hackffm/FPVCar/python/web/00_Orientation_Size/horizontal.jpg

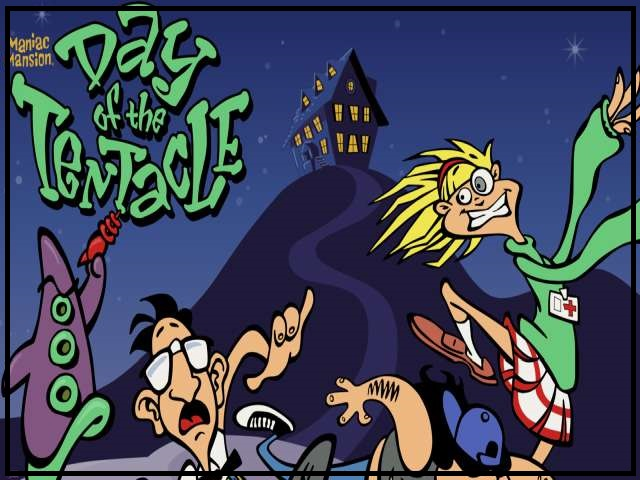
python/web/00_Orientation_Size/horizontal.jpg
