hackffm/FPVCar/python/web/00_Orientation_Size/vertical.jpg

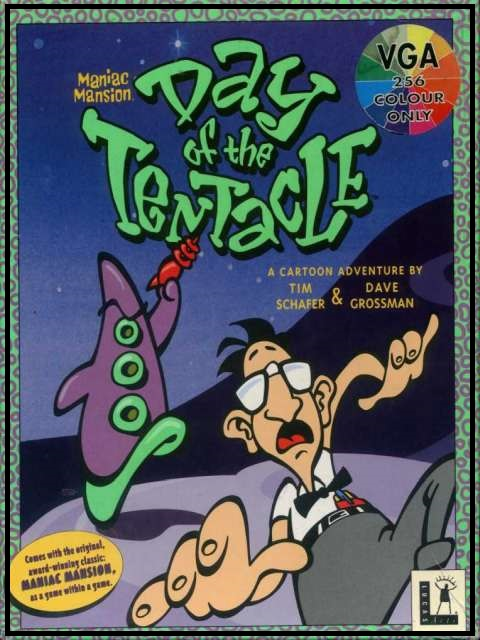
python/web/00_Orientation_Size/vertical.jpg
