hackffm/FPVCar/README.md

# FPVCar
First Person View Car

## Project Page
[FPV_Auto](https://hackerspace-ffm.de/wiki/index.php?title=FPV-Auto) @ HackFFM
