hackffm/FPVCar/PCB/Block diagram FPV Auto Shield.png

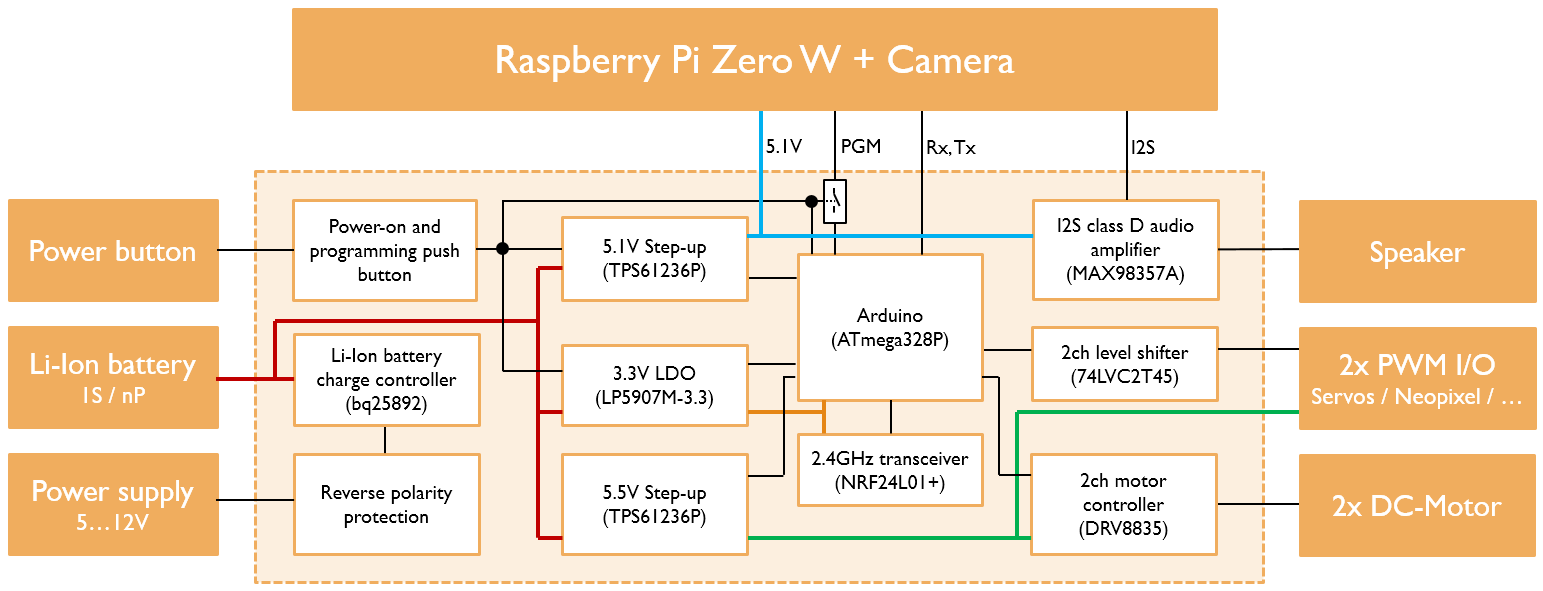
PCB/Block diagram FPV Auto Shield.png
