hackffm/FPVCar/PCB/MountBottomFirst.png

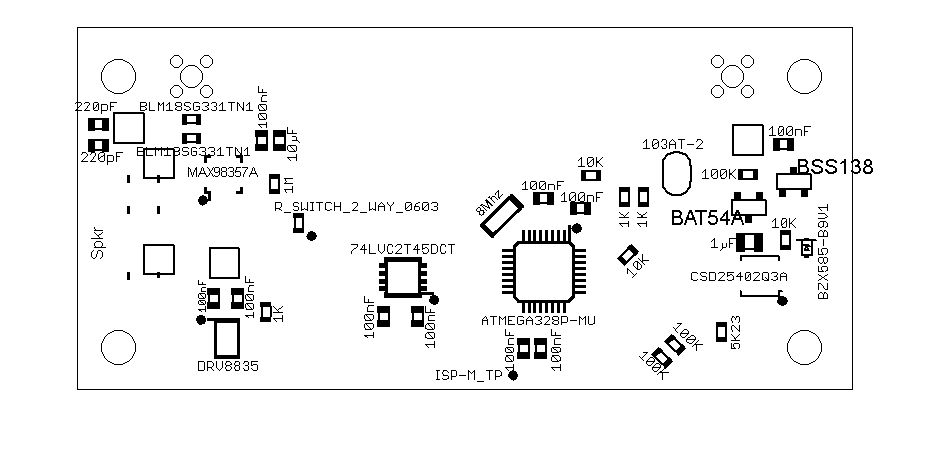
PCB/MountBottomFirst.png
