hackffm/FPVCar/PCB/MountTopSecond.png

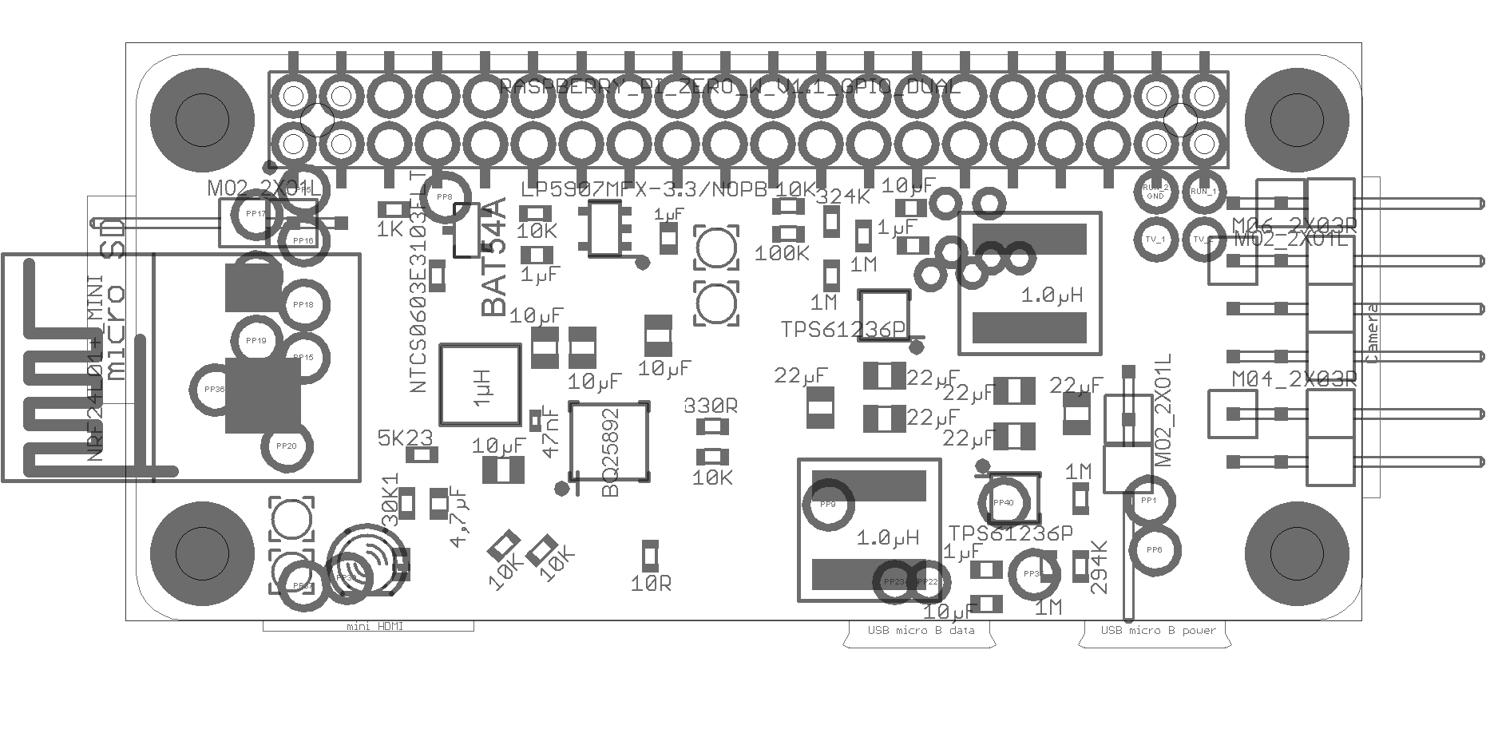
PCB/MountTopSecond.png
