hackffm/FPVCar/(threads)

Thread 1 (2019-05-06):

Wire.requestFrom() should not be followed by Wire.endTransmission().

Koepel, 2019-05-06:
In the file "FPVCar/arduino/FPVAutoControl/FPVAutoControl.ino" the `Wire.requestFrom()` is followed by a `Wire.endTransmission()`. That `Wire.endTransmission()` is at the moment at line 60 and may be removed.
Explanation: [Common-mistakes#2](https://github.com/Koepel/How-to-use-the-Arduino-Wire-library/wiki/Common-mistakes#2)

vkuehn, 2019-11-18:
this has been now fixed

Closed 2019-11-18.
