hackffm/FPVCar/PCB/FPV-Auto Schematic.pdf

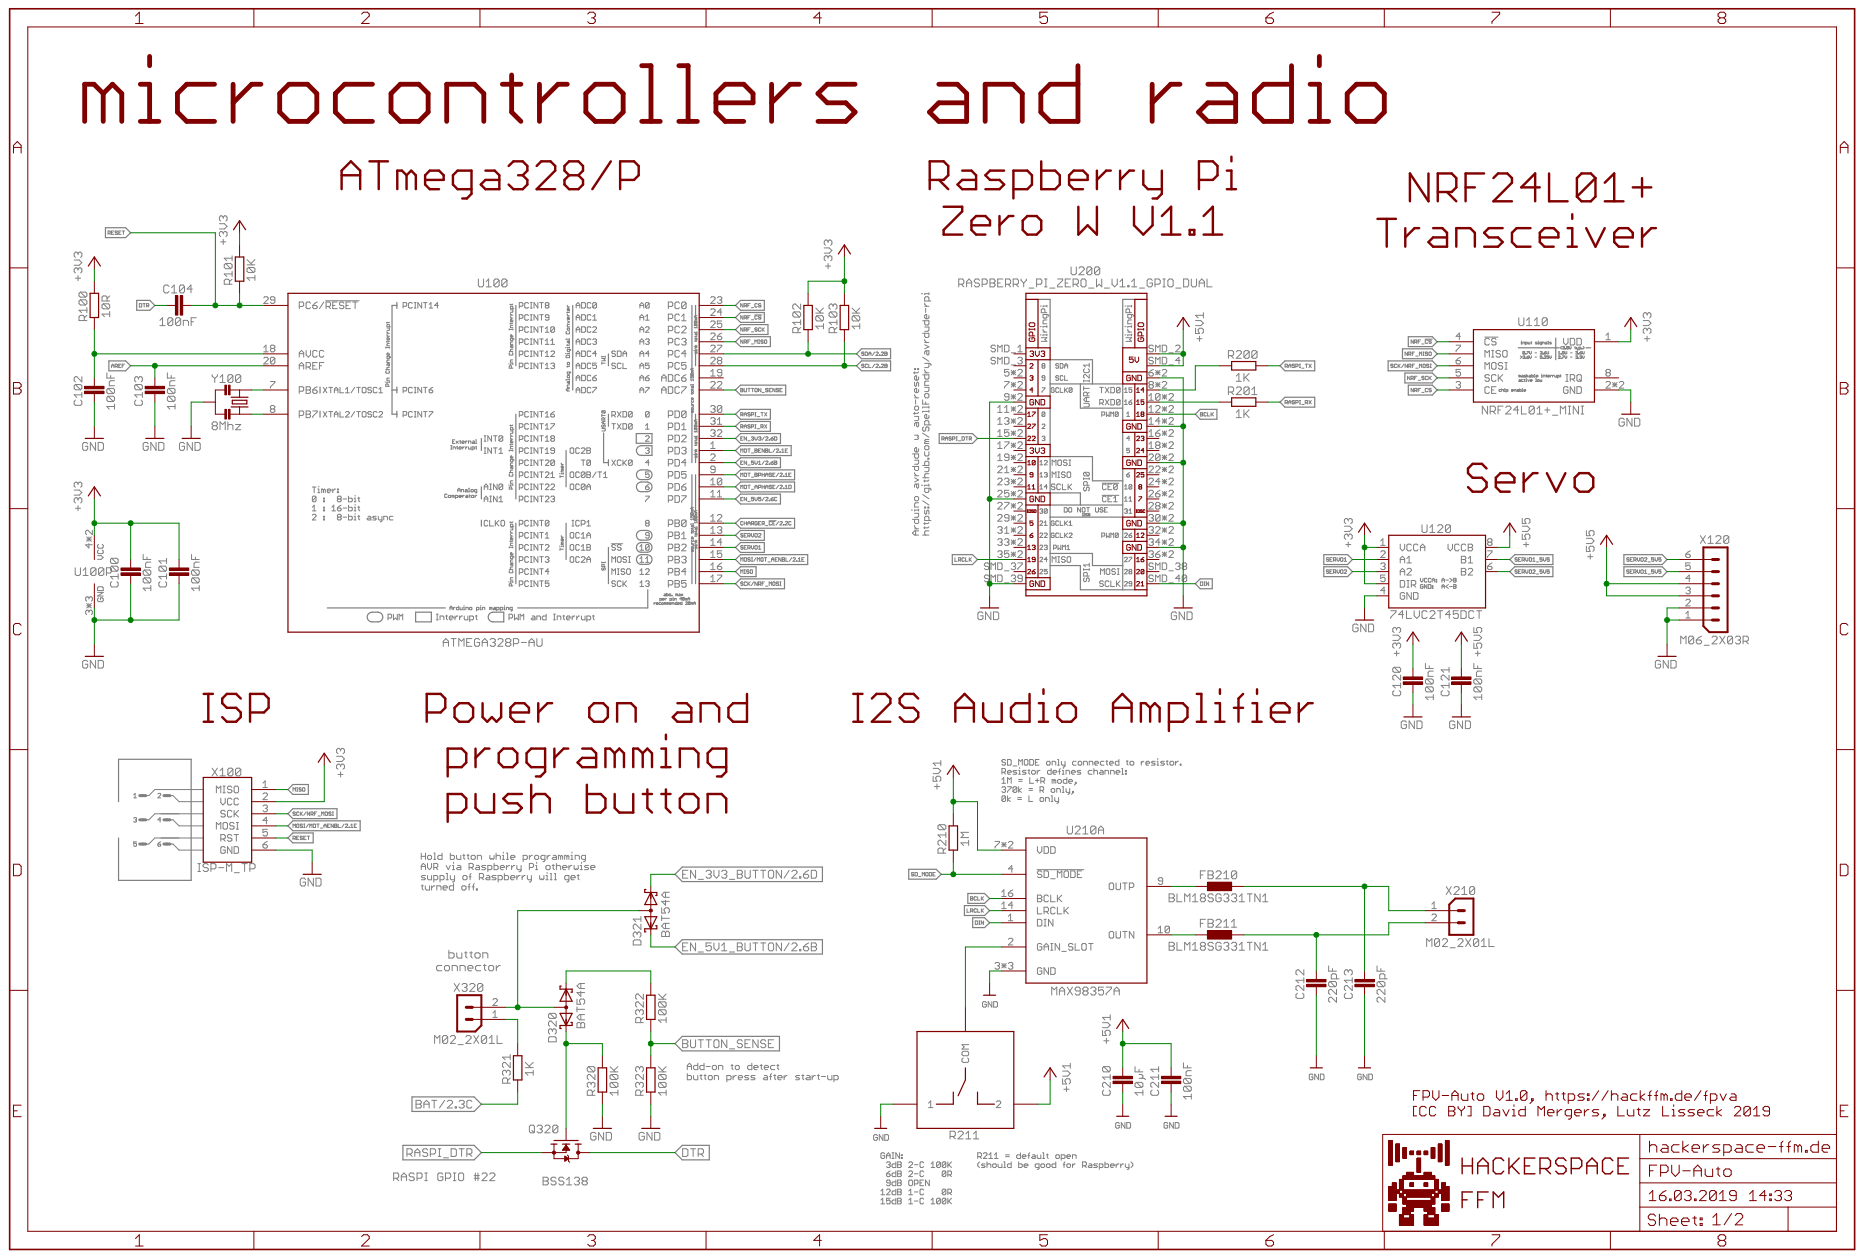
[picture p6: page 1]

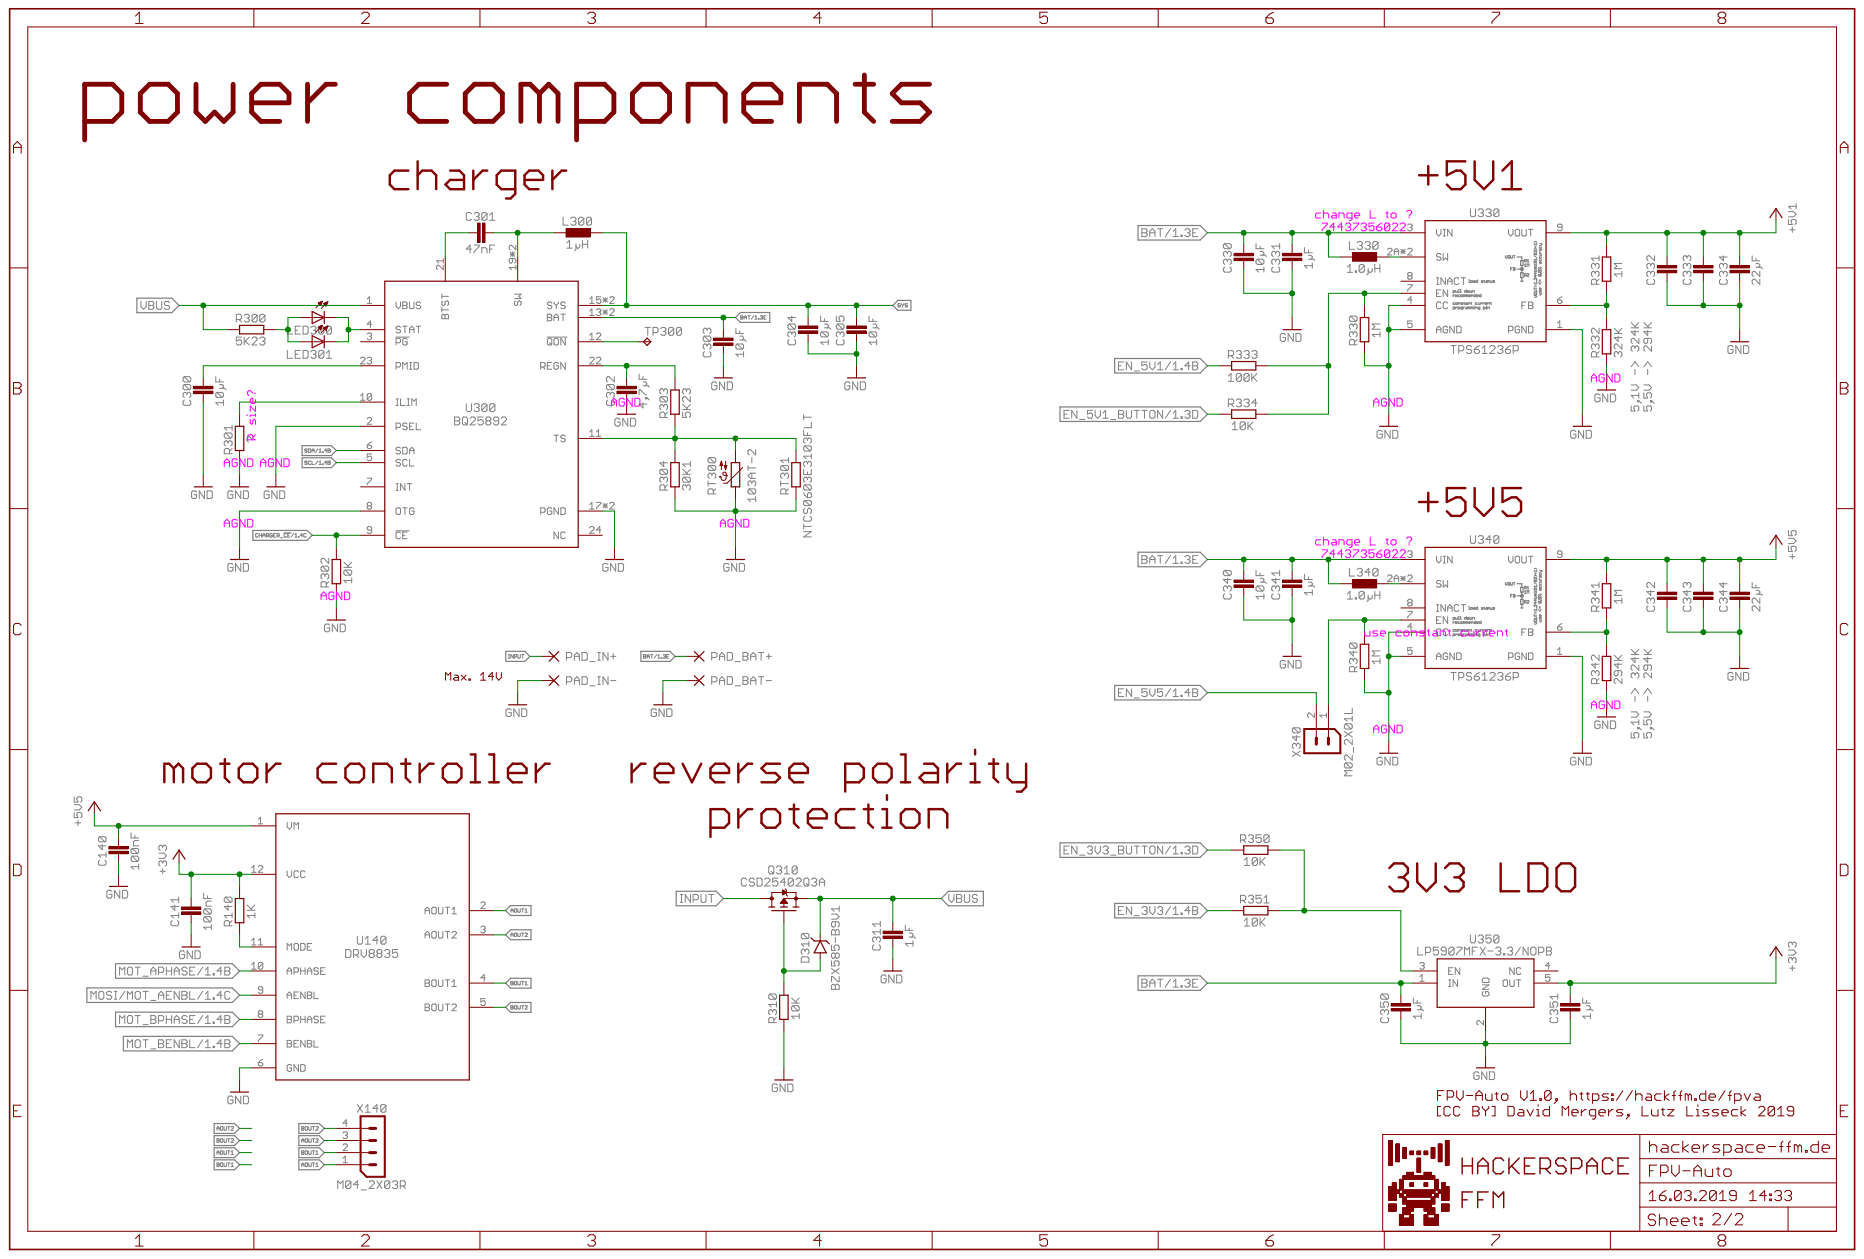
[picture p7: page 2]
