hackffm/FPVCar/(list of files, drawings)

Other design files:
arduino/hardware/FPVAuto/avr/avrdude-gpio-autoreset/diagrams/RPi Arduino Wire Up (Fritzing).fzz
