hackffm/FPVCar/PCB/FPV-Auto.brd

## EAGLE design PCB/FPV-Auto.brd (2019-08-17)

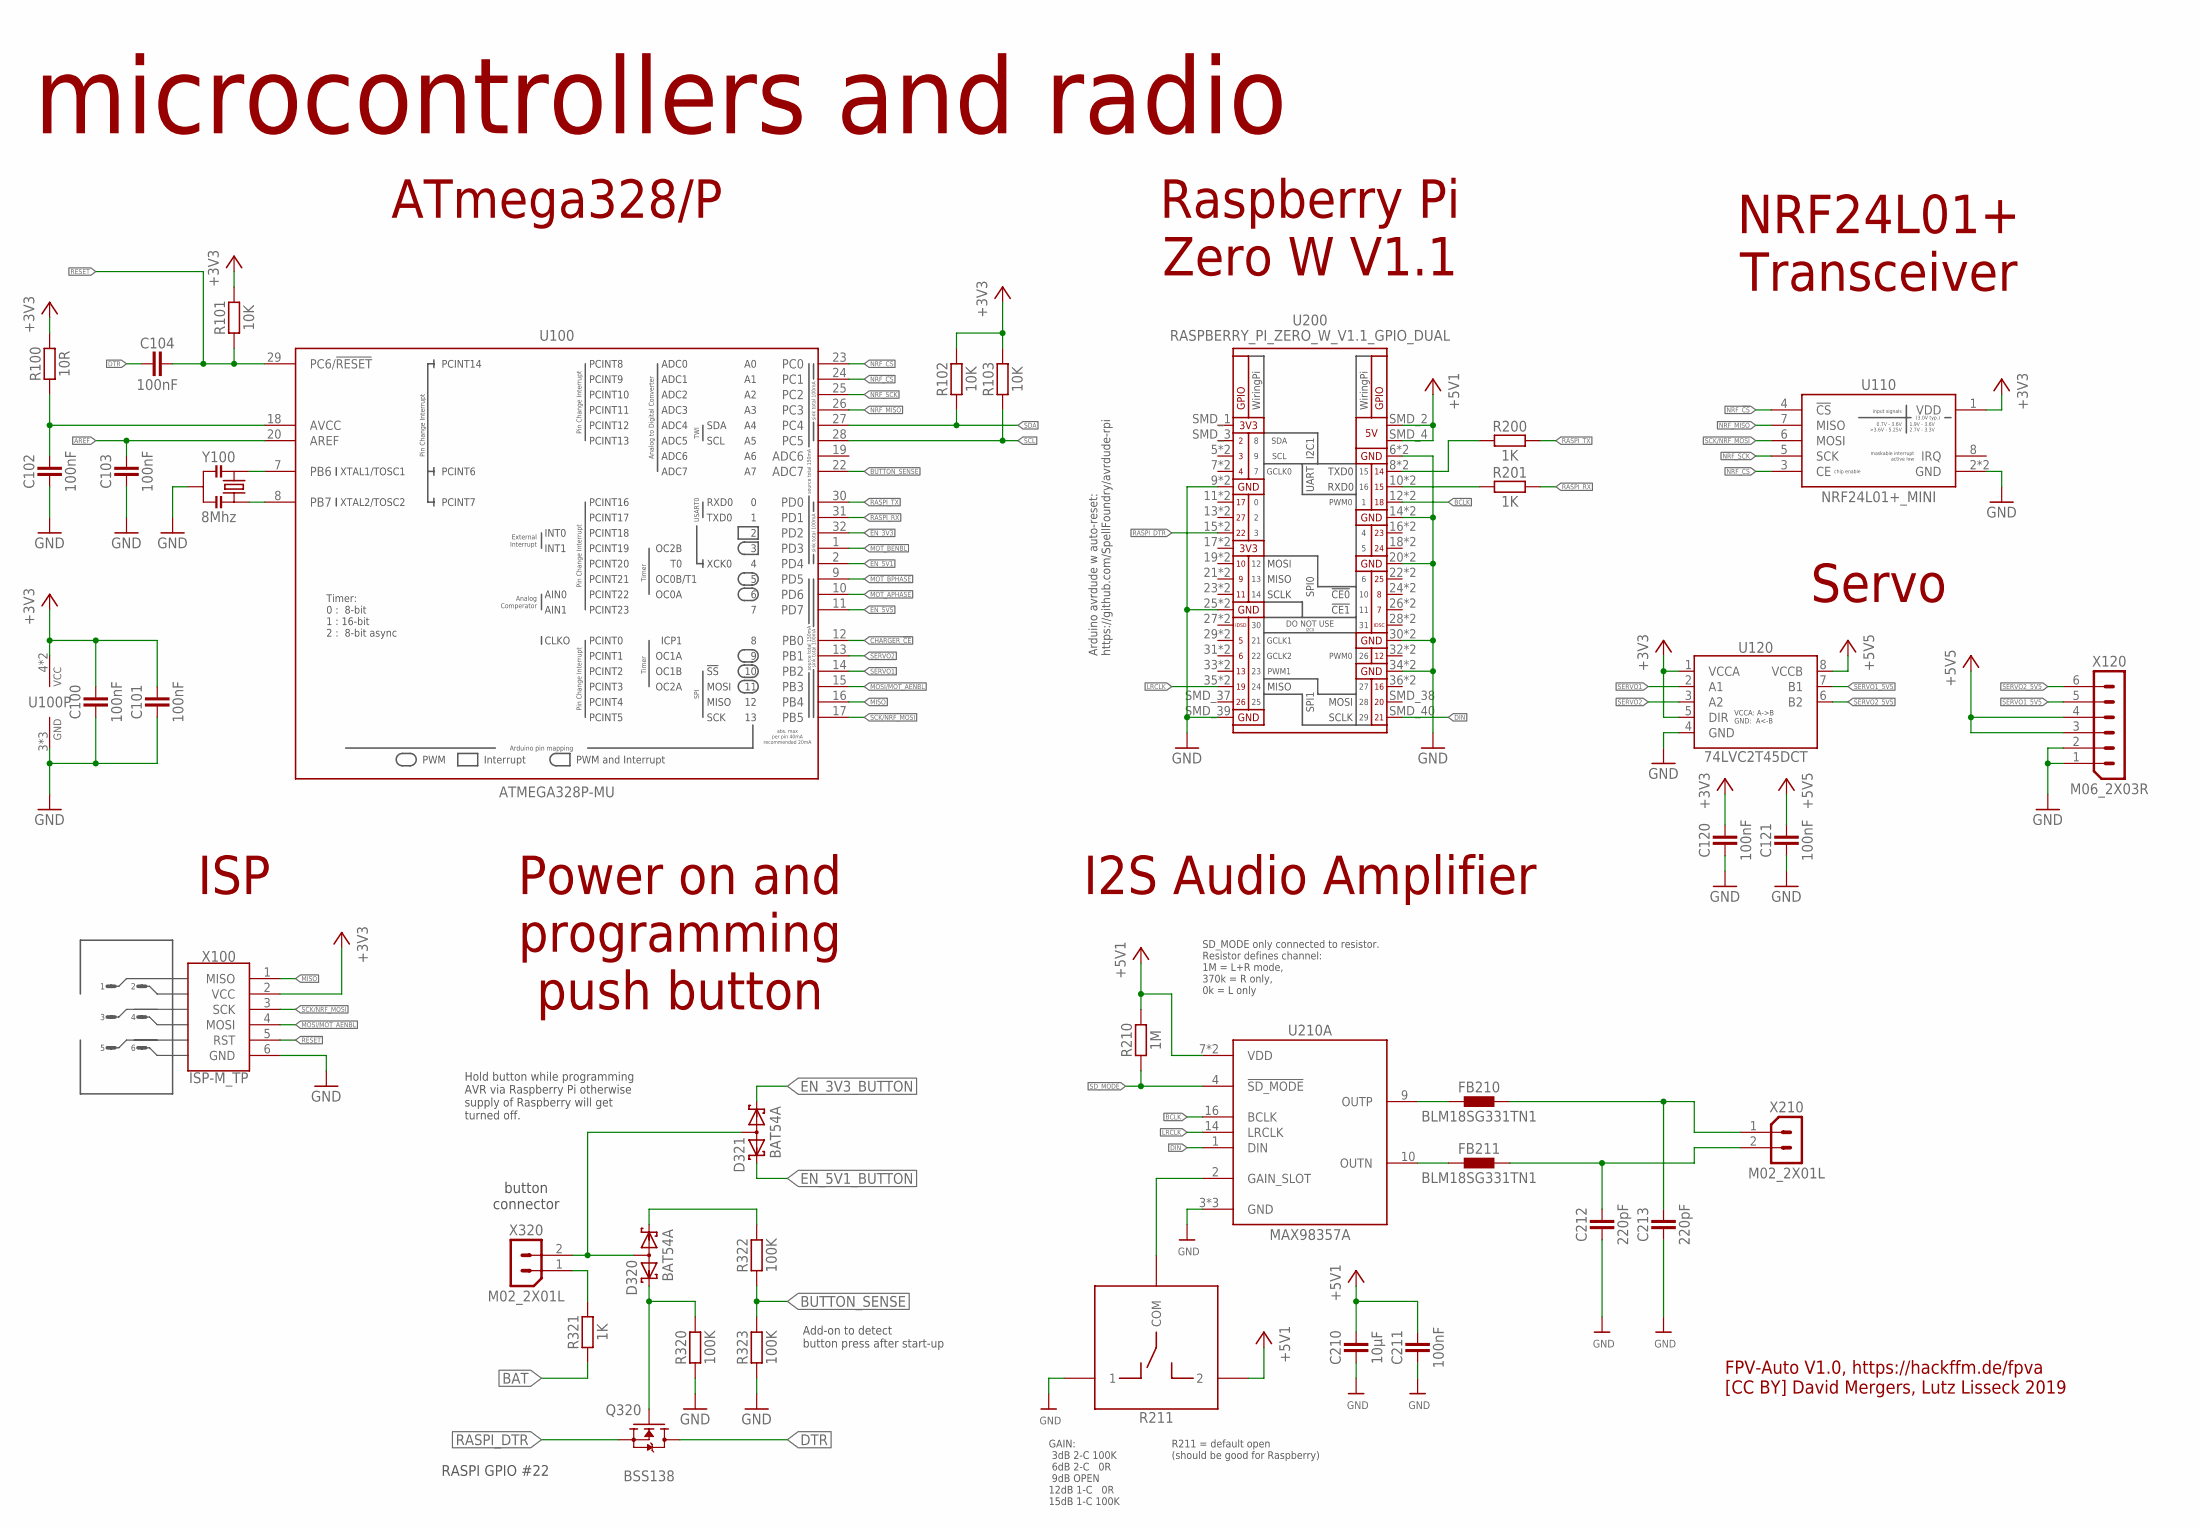
[picture p8: schematic FPV-Auto.sch, sheet 1]

Parts:
C100, C101, C102, C103, C104, C120, C121, C211: 100nF; C0603
C210: 10µF; C0603
C212, C213: 220pF; C0603
D320, D321: BAT54A; SOT23
FB210, FB211: BLM18SG331TN1; 0603
Q320: BSS138; SOT23-3
R100: 10R; R0603
R101, R102, R103: 10K; R0603
R200, R201, R321: 1K; R0603
R210: 1M; R0603
R211: R_SWITCH_2_WAY_0603; R0603_SWITCH_2_WAY
R320, R322, R323: 100K; R0603
U100: ATMEGA328P-MU; PBS(S-PQFP-G32)
U110: NRF24L01+_MINI
U120: 74LVC2T45DCT; DCT(R-PDSO-G8)
U200: RASPBERRY_PI_ZERO_W_V1.1_GPIO_DUAL
U210: MAX98357A; 90-0031
X100: ISP-M_TP
X120: M06_2X03R; M2X03R
X210, X320: M02_2X01L; M2X01L
Y100: 8Mhz; CSTNE

Connections:
+3V3: C100.1, C101.1, C120.1, R100.2, R101.2, R102.2, R103.2, U100.4 (VCC), U100.6 (VCC), U110.1 (VDD), U120.1 (VCCA), U120.5 (DIR), X100.2 (VCC); also elsewhere on the board
+5V1: C210.1, C211.1, R210.2, R211.2, U200.SMD_2 (5V), U200.SMD_4 (5V), U210.7 (VDD), U210.8 (VDD); also elsewhere on the board
+5V5: C121.1, U120.8 (VCCB), X120.3, X120.4; also elsewhere on the board
AREF: C103.1, U100.20 (AREF)
BAT: R321.2; also elsewhere on the board
BCLK: U200.12 (GPIO18), U200.SMD_12 (GPIO18), U210.16 (BCLK)
BUTTON_SENSE: R322.1, R323.2, U100.22 (ADC7)
CHARGER_!CE: U100.12 (PB0); also elsewhere on the board
DIN: U200.SMD_40 (GPIO21), U210.1 (DIN)
DTR: C104.2, Q320.3 (D)
EN_3V3: U100.32 (PD2); also elsewhere on the board
EN_3V3_BUTTON: D321.1 (K1); also elsewhere on the board
EN_5V1: U100.2 (PD4); also elsewhere on the board
EN_5V1_BUTTON: D321.2 (K2); also elsewhere on the board
EN_5V5: U100.11 (PD7); also elsewhere on the board
GAIN: R211.COM, U210.2 (GAIN_SLOT)
GND: C100.2, C101.2, C102.2, C103.2, C120.2, C121.2, C210.2, C211.2, C212.2, C213.2, R211.1, R320.1, R323.1, U100.3 (GND), U100.5 (GND), U100.21 (GND), U110.2 (GND), U110.9 (GND), U120.4 (GND), U200.6 (GND), U200.9 (GND), U200.14 (GND), U200.20 (GND), U200.25 (GND), U200.30 (GND), U200.34 (GND), U200.SMD_6 (GND), U200.SMD_9 (GND), U200.SMD_14 (GND), U200.SMD_20 (GND), U200.SMD_25 (GND), U200.SMD_30 (GND), U200.SMD_34 (GND), U200.SMD_39 (GND), U210.3 (GND), U210.11 (GND), U210.15 (GND), U210.TP0 (GND), U210.TP1 (GND), X100.6 (GND), X120.1, X120.2, Y100.2; also elsewhere on the board
LRCLK: U200.35 (GPIO19), U200.SMD_35 (GPIO19), U210.14 (LRCLK)
MISO: U100.16 (PB4), X100.1 (MISO)
MOSI/MOT_AENBL: U100.15 (PB3), X100.4 (MOSI); also elsewhere on the board
MOT_APHASE: U100.10 (PD6); also elsewhere on the board
MOT_BENBL: U100.1 (PD3); also elsewhere on the board
MOT_BPHASE: U100.9 (PD5); also elsewhere on the board
unnamed: D320.3 (AA), D321.3 (AA), X320.2
unnamed: FB211.1, U210.10 (OUTN)
unnamed: FB210.1, U210.9 (OUTP)
unnamed: U100.8 (PB7), Y100.3
unnamed: U100.7 (PB6), Y100.1
unnamed: D320.2 (K2), R322.2
unnamed: D320.1 (K1), Q320.1 (G), R320.2
unnamed: R321.1, X320.1
unnamed: C102.1, R100.1, U100.18 (AVCC)
unnamed: R200.1, U200.8 (GPIO14/TXD0), U200.SMD_8 (GPIO14/TXD0)
unnamed: R201.1, U200.10 (GPIO15/RXD0), U200.SMD_10 (GPIO15/RXD0)
NRF_!CS: U100.24 (PC1), U110.4 (!CS)
NRF_CS: U100.23 (PC0), U110.3 (CE)
NRF_MISO: U100.26 (PC3), U110.7 (MISO)
NRF_SCK: U100.25 (PC2), U110.5 (SCK)
RASPI_DTR: Q320.2 (S), U200.15 (GPIO22/GEN3), U200.SMD_15 (GPIO22/GEN3)
RASPI_RX: R201.2, U100.31 (PD1)
RASPI_TX: R200.2, U100.30 (PD0)
RESET: C104.1, R101.1, U100.29 (PC6/!RESET!), X100.5 (RST)
SCK/NRF_MOSI: U100.17 (PB5), U110.6 (MOSI), X100.3 (SCK)
SCL: R103.1, U100.28 (PC5); also elsewhere on the board
SDA: R102.1, U100.27 (PC4); also elsewhere on the board
SD_MODE: R210.1, U210.4 (!SD_MODE)
SERVO1: U100.14 (PB2), U120.2 (A1)
SERVO1_5V5: U120.7 (B1), X120.5
SERVO2: U100.13 (PB1), U120.3 (A2)
SERVO2_5V5: U120.6 (B2), X120.6
VO+: C213.1, FB210.2, X210.1
VO-: C212.1, FB211.2, X210.2

Notes on the sheet:
microcontrollers and radio
NRF24L01+ Transceiver
Raspberry Pi Zero W V1.1
ATmega328/P
GAIN: 3dB 2-C 100K 6dB 2-C 0R 9dB OPEN 12dB 1-C 0R 15dB 1-C 100K
ISP
I2S Audio Amplifier
Servo
button connector
RASPI GPIO #22
Power on and programming push button
SD_MODE only connected to resistor. Resistor defines channel: 1M = L+R mode, 370k = R only, 0k = L only
R211 = default open (should be good for Raspberry)
Arduino avrdude w auto-reset: https://github.com/SpellFoundry/avrdude-rpi
Hold button while programming AVR via Raspberry Pi otherwise supply of Raspberry will get turned off.
Add-on to detect button press after start-up
FPV-Auto V1.0, https://hackffm.de/fpva [CC BY] David Mergers, Lutz Lisseck 2019

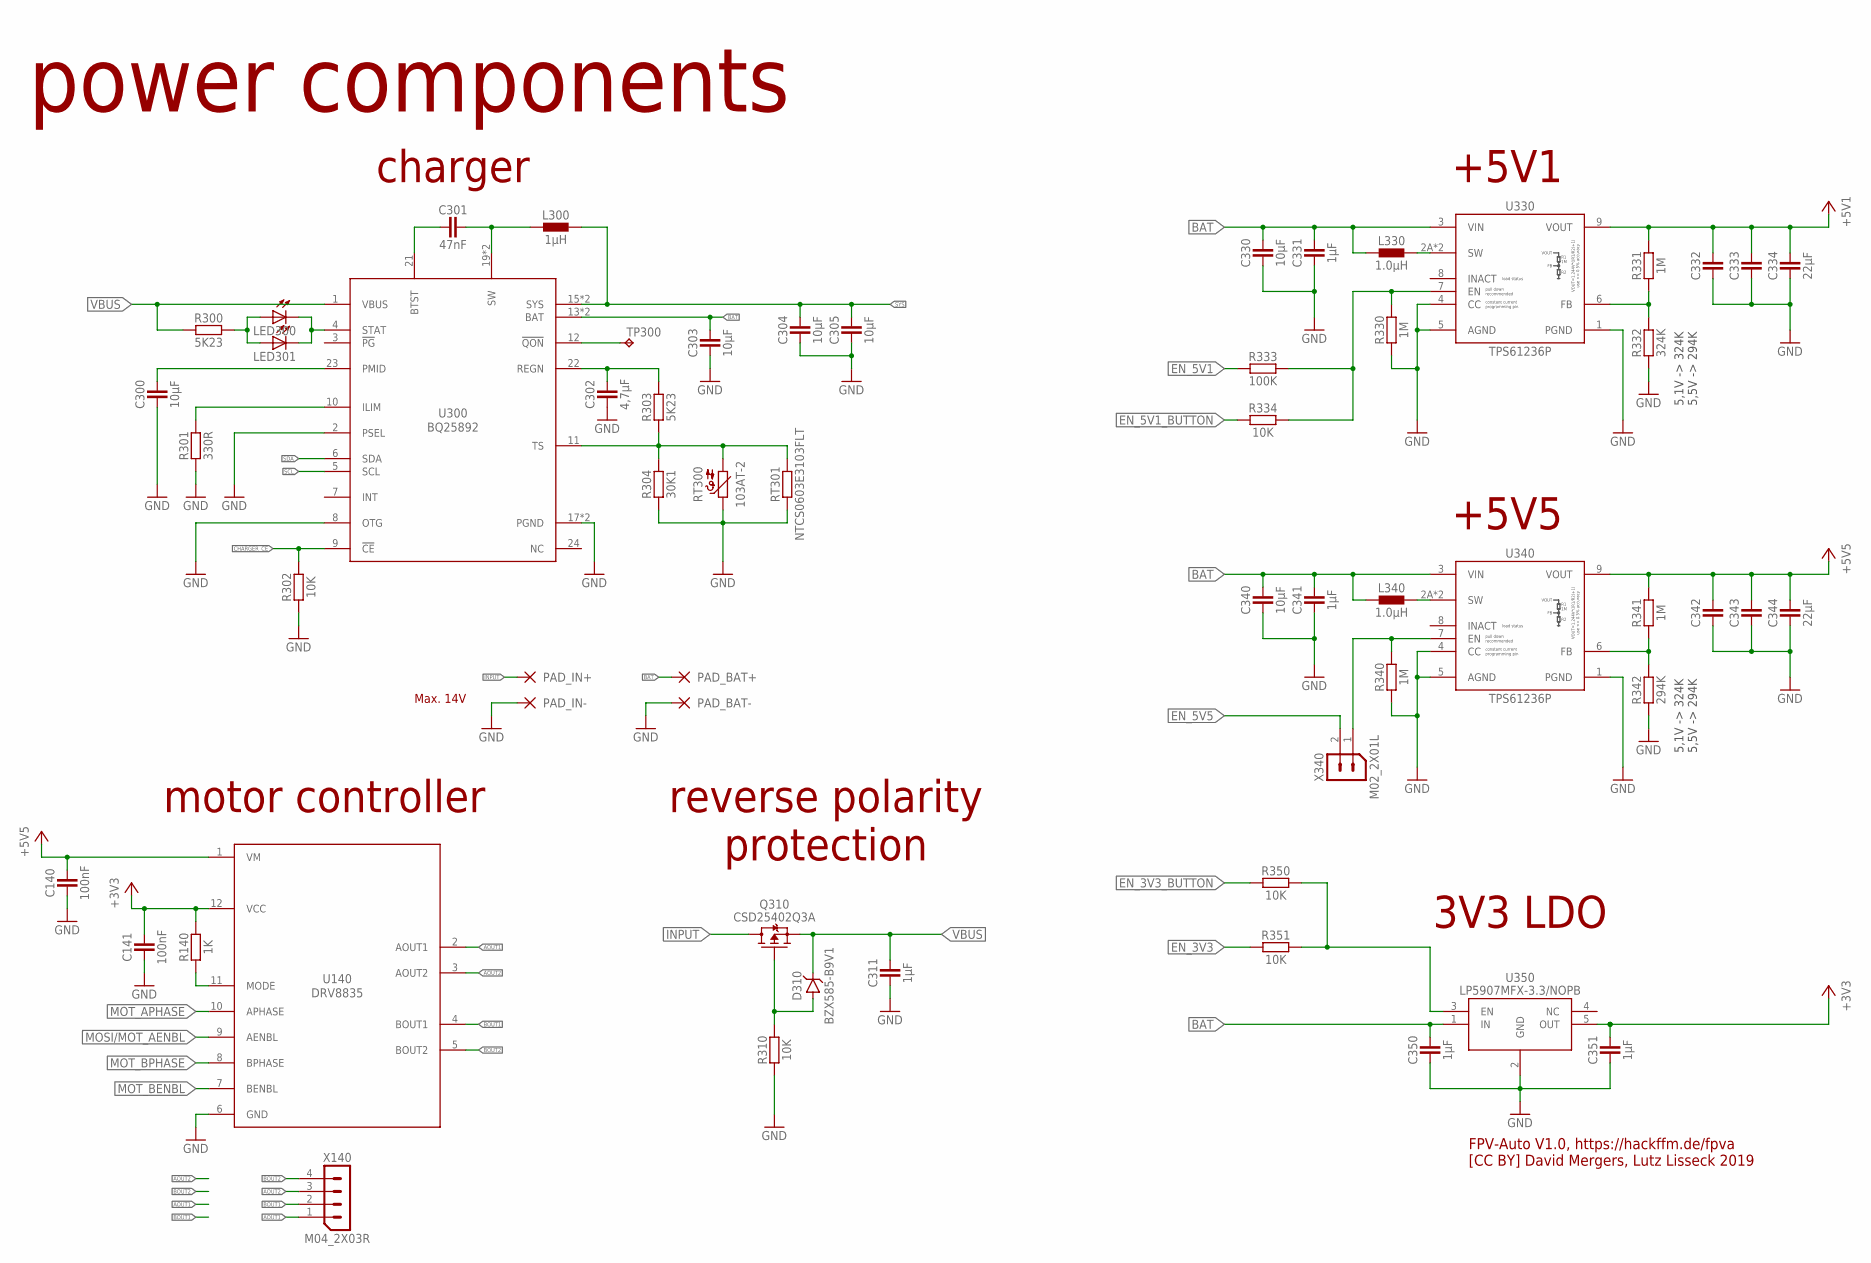
[picture p9: schematic FPV-Auto.sch, sheet 2]

Parts:
C140, C141: 100nF; C0603
C300, C303, C304, C305: 10µF; C0805
C301: 47nF; C0402
C302: 4,7µF; C0603
C311: 1µF; C0805
C330, C340: 10µF; C0603
C331, C341, C350, C351: 1µF; C0603
C332, C333, C334, C342, C343, C344: 22µF; C0805
D310: BZX585-B9V1; SOD523(SC-79)
L300: 1µH; 4030
L330, L340: 1.0µH; XAL7030
LED300: LEDCHIP-LED0603; CHIP-LED0603
LED301: LED3MM
PAD_BAT+: WIREPAD2,15/1,0; 2,15/1,0
PAD_BAT-: WIREPAD2,15/1,0; 2,15/1,0
PAD_IN+: WIREPAD2,15/1,0; 2,15/1,0
PAD_IN-: WIREPAD2,15/1,0; 2,15/1,0
Q310: CSD25402Q3A; Q3A
R140: 1K; R0603
R300, R303: 5K23; R0603
R301: 330R; R0603
R302, R310, R334, R350, R351: 10K; R0603
R304: 30K1; R0603
R330, R331, R340, R341: 1M; R0603
R332: 324K; R0603
R333: 100K; R0603
R342: 294K; R0603
RT300: 103AT-2; AT-2
RT301: NTCS0603E3103FLT; R0603
TP300: TPB1,27; B1,27
U140: DRV8835; DSS(WSON-12)
U300: BQ25892; RTW(S-PWQFN-N24)_LONG
U330, U340: TPS61236P; RWL(S-PQFP-N9)_LONG
U350: LP5907MFX-3.3/NOPB; DBV(R-PDSO-G5)
X140: M04_2X03R; M2X02R
X340: M02_2X01L; M2X01L

Connections:
+3V3: C141.1, C351.1, R140.1, U140.12 (VCC), U350.5 (OUT); also elsewhere on the board
+5V1: C332.1, C333.1, C334.1, R331.2, U330.9 (VOUT); also elsewhere on the board
+5V5: C140.1, C342.1, C343.1, C344.1, R341.2, U140.1 (VM), U340.9 (VOUT); also elsewhere on the board
AOUT1: U140.2 (AOUT1), X140.1
AOUT2: U140.3 (AOUT2), X140.3
BAT: C303.1, C330.1, C331.1, C340.1, C341.1, C350.1, L330.1, L340.1, PAD_BAT+.1, U300.13 (BAT), U300.14 (BAT), U330.3 (VIN), U340.3 (VIN), U350.1 (IN); also elsewhere on the board
BOUT1: U140.4 (BOUT1), X140.2
BOUT2: U140.5 (BOUT2), X140.4
CHARGER_!CE: R302.2, U300.9 (!CE); also elsewhere on the board
EN_3V3: R351.1; also elsewhere on the board
EN_3V3_BUTTON: R350.1; also elsewhere on the board
EN_3V3_JMP: R350.2, R351.2, U350.3 (EN)
EN_5V1: R333.1; also elsewhere on the board
EN_5V1_BUTTON: R334.1; also elsewhere on the board
EN_5V1_JMP: R330.2, R333.2, R334.2, U330.7 (EN)
EN_5V5: X340.2; also elsewhere on the board
EN_5V5_JMP: R340.2, U340.7 (EN), X340.1
GND: C140.2, C141.2, C300.2, C302.2, C303.2, C304.2, C305.2, C311.2, C330.2, C331.2, C332.2, C333.2, C334.2, C340.2, C341.2, C342.2, C343.2, C344.2, C350.2, C351.2, PAD_BAT-.1, PAD_IN-.1, R301.1, R302.1, R304.1, R310.1, R330.1, R332.1, R340.1, R342.1, RT300.P$1 (1), RT301.1, U140.6 (GND), U140.TP (GND), U140.TP1 (GND), U140.TP2 (GND), U140.TP3 (GND), U300.2 (PSEL), U300.8 (OTG), U300.17 (PGND), U300.18 (PGND), U300.TP0 (GND), U300.TP1 (GND), U300.TP2 (GND), U300.TP3 (GND), U300.TP4 (GND), U300.TP5 (GND), U300.TP6 (GND), U300.TP7 (GND), U300.TP8 (GND), U300.TP9 (GND), U330.1 (PGND), U330.4 (CC), U330.5 (AGND), U340.1 (PGND), U340.4 (CC), U340.5 (AGND), U350.2 (GND); also elsewhere on the board
INPUT: PAD_IN+.1, Q310.1 (D), Q310.2 (D), Q310.3 (D)
MOSI/MOT_AENBL: U140.9 (AENBL); also elsewhere on the board
MOT_APHASE: U140.10 (APHASE); also elsewhere on the board
MOT_BENBL: U140.7 (BENBL); also elsewhere on the board
MOT_BPHASE: U140.8 (BPHASE); also elsewhere on the board
unnamed: L330.2, U330.2A (SW), U330.2B (SW)
unnamed: L340.2, U340.2A (SW), U340.2B (SW)
unnamed: R341.1, R342.2, U340.6 (FB)
unnamed: R331.1, R332.2, U330.6 (FB)
unnamed: TP300.TP, U300.12 (!QON)
unnamed: R303.1, R304.2, RT300.P$2 (2), RT301.2, U300.11 (TS)
unnamed: C302.1, R303.2, U300.22 (REGN)
unnamed: R301.2, U300.10 (ILIM)
unnamed: C301.2, U300.21 (BTST)
unnamed: C301.1, L300.P$1 (1), U300.19 (SW), U300.20 (SW)
unnamed: D310.A, Q310.4 (G), R310.2
unnamed: C300.1, U300.23 (PMID)
unnamed: LED300.C, LED301.K (C), U300.4 (STAT)
unnamed: LED300.A, LED301.A, R300.1
unnamed: R140.2, U140.11 (MODE)
SCL: U300.5 (SCL); also elsewhere on the board
SDA: U300.6 (SDA); also elsewhere on the board
SYS: C304.1, C305.1, L300.P$2 (2), U300.15 (SYS), U300.16 (SYS)
VBUS: C311.1, D310.C, Q310.TP0 (S), Q310.TP1 (S), Q310.TP2 (S), Q310.TP3 (S), Q310.TP4 (S), Q310.TP5 (S), Q310.TP6 (S), Q310.TP7 (S), R300.2, U300.1 (VBUS)

Notes on the sheet:
power components
+5V1
motor controller
3V3 LDO
5,1V -> 324K 5,5V -> 294K
+5V5
charger
reverse polarity protection
Max. 14V
FPV-Auto V1.0, https://hackffm.de/fpva [CC BY] David Mergers, Lutz Lisseck 2019

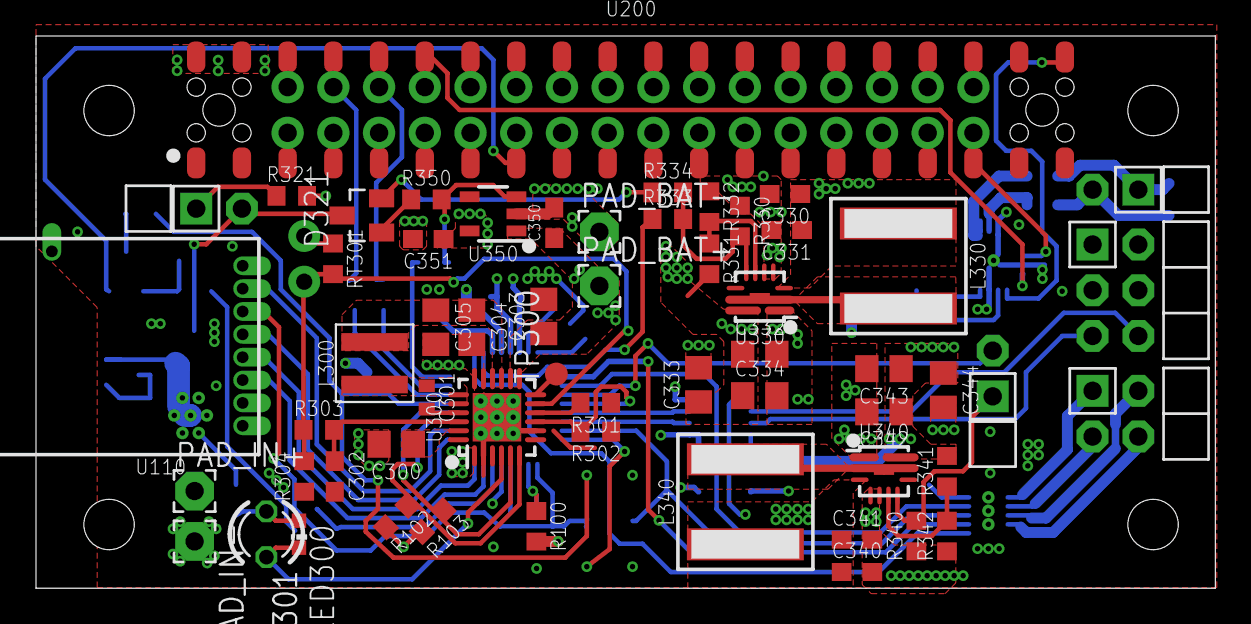
[picture p10: board FPV-Auto.brd from above]

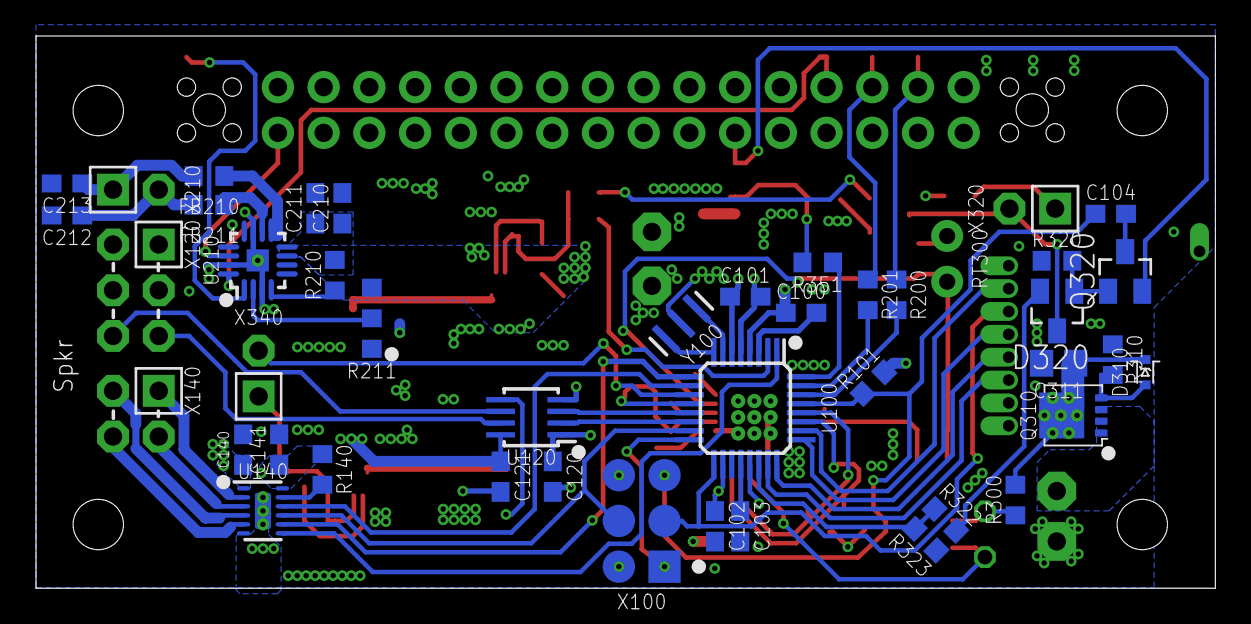
[picture p11: board FPV-Auto.brd from below]

Board: 4 copper layers, 65.5 x 30.7 mm, 99 parts (40 on the bottom side), 77 nets.

Other parts of the board:
U$3: HACKFFM_LOGO_STOP
U$9: DATE
