hackffm/FPVCar/python/tornado/03_web_control/components/base.py

from . import Component


class Base(Component):
    """control movements of base"""

    def __init__(self, ser, debug=False):
        name = 'base'
        super().__init__(name)
        self.debug = debug
        self.ser = ser

    def handleMessage(self, message):
        result = 'unknown command'

        if self.debug:
            print(self.name + ' recieved ' + str(message))

        if "right" in message:
            result = self.move_left_right(message)
        return result

    def move_left_right(self, message):
        cmd = "f" + str(message["right"]) + " " + str(message["left"]) + "\r"
        if self.debug:
            print("move_left_right: " + cmd)
        self.ser.write(cmd.encode())
        return ''

    def do_move(self, command):
        result = 'move base ' + command
        return result
