hackffm/FPVCar/python/tornado/03_web_control/components/component.py

class Component(object):
    """docstring for Component."""

    def __init__(self, name, debug=False):
        self.debug = debug
        self.failed = 'failed'
        self.name = name

    def handle_message(self, message):
        print(message)
