hackffm/FPVCar/python/tornado/03_web_control/tools/test/test_config.py

import helper_test

from resources import *

config = Config(debug=True)

configuration = config.configuration
config.configuration['audio'] = 'none'
print(config.configuration)
config.save()
config.load()
config.configuration['audio'] = 'off'
config.configuration['test'] = 'test'
print(config.configuration)
config.save()
cfg = config.cfg()
print(cfg.audio)
print(cfg.baud)
print(cfg.debug)
print(cfg.port)
print(type(cfg.sensors.bno055))
if cfg.sensors.bno055:
    print('bno055 attached')
else:
    print('bno055 not attached')
