hackffm/FPVCar/(commit log)

2018-08-15 Serial command dispatcher and motor driver
2018-08-16 added webserver from the spacerex project
2018-08-20 changed driving the DRV8833 from two PWMs to one PWM for one tire pair
2019-02-27 added: PCB-Layout
    [FPV-Auto.brd, FPV-Auto.sch]
2019-03-01 Changes on Raspberry GPIO assignment
    [FPV-Auto.brd, FPV-Auto.sch]
2019-03-02 Update PCB Layout
    [FPV-Auto.brd, FPV-Auto.sch]
2019-03-03 Z-Diode on reverse-prot-mosfet, button also on AVR, other minor changes
    [FPV-Auto.brd, FPV-Auto.sch]
2019-03-04 updated lib and pcb
    [FPV-Auto.brd, FPV-Auto.sch]
2019-03-05 Updated PCB
    [FPV-Auto.brd, FPV-Auto.sch]
2019-03-11 Add BOM
    [BOM.csv]
2019-03-15 Board Layout Update
    changed mask, changed 0402 caps -> 0603
    [FPV-Auto.brd, FPV-Auto.sch]
2019-03-16 Silkscreen and Schematic Docu updates
    [FPV-Auto.brd, FPV-Auto.sch]
2019-03-17 Schematic PDF added
2019-03-17 Updated BOM
    [BOM.csv]
2019-04-25 Arduino hardware folder for easy use added
    [RPi Arduino Wire Up (Fritzing).fzz]
2019-04-29 Motor and Servo works now
2019-05-06 I2C commands added for charger communication
2019-05-26 facial expressions for oled i2c display with 128x64
2019-06-04 fixed the serial channel to the website. was broken when we changed to python3
    [server_p3.py]
2019-06-04 add V for reading the bus voltage(input voltage)
2019-06-06 the chuncks of serial data from arduino are consolidated to commands within the python webserver. vbat and vbus are displayed on the webinterface
2019-07-17 remove unwanted files. commit missed commits
    [component.py, server.py]
2019-07-22 switched back from flask to tornado because of massive performance problems with socketio
    [script.js, server_p3.py]
2019-07-30 change clickable button to div
2019-08-03 Added part mounting plan
    [FPV-Auto.brd]
2019-10-20 add option for all sensor values at once
2019-10-20 change back wrongly edited file
    [stats.py]
2019-10-20 rework to handle return value from components. not working nicely now
    [bno055.py, component.py, script.js, server.py]
2019-10-21 works, but unclear why sensor values only updated in tests cases
2019-10-26 additional infos in print
2019-10-27 add calibration status
2019-11-04 328p added in Arduino Raspberry Boards
2019-11-18 enabled gauges and shutdown button
2019-11-18 pcb partlist doku
    [bottom-partlist.ods]
2019-11-25 fpv web ui. mostly clean v1. Gauges can't be hidden currently
2019-12-02 remove double component is valid check. Get some missing stuff from backports
    [base.py, bno055.py, cam.py, component.py, sound.py, stats.py]
2019-12-11 start sensors(bno055) to be configurable if present
2019-12-12 better socket handling. add test_component_base to start base handling
2019-12-14 Update bno055.py
    remove noisy debug message from sensor
2019-12-27 add basic camera test
2019-12-30 page reload when camera starts or stops
